OHNope/seeed-xiao-studio-nose-camera/rocket_nose_selfie_camera.kicad_sch

## KiCad design rocket_nose_selfie_camera.kicad_sch (2026-10-16)

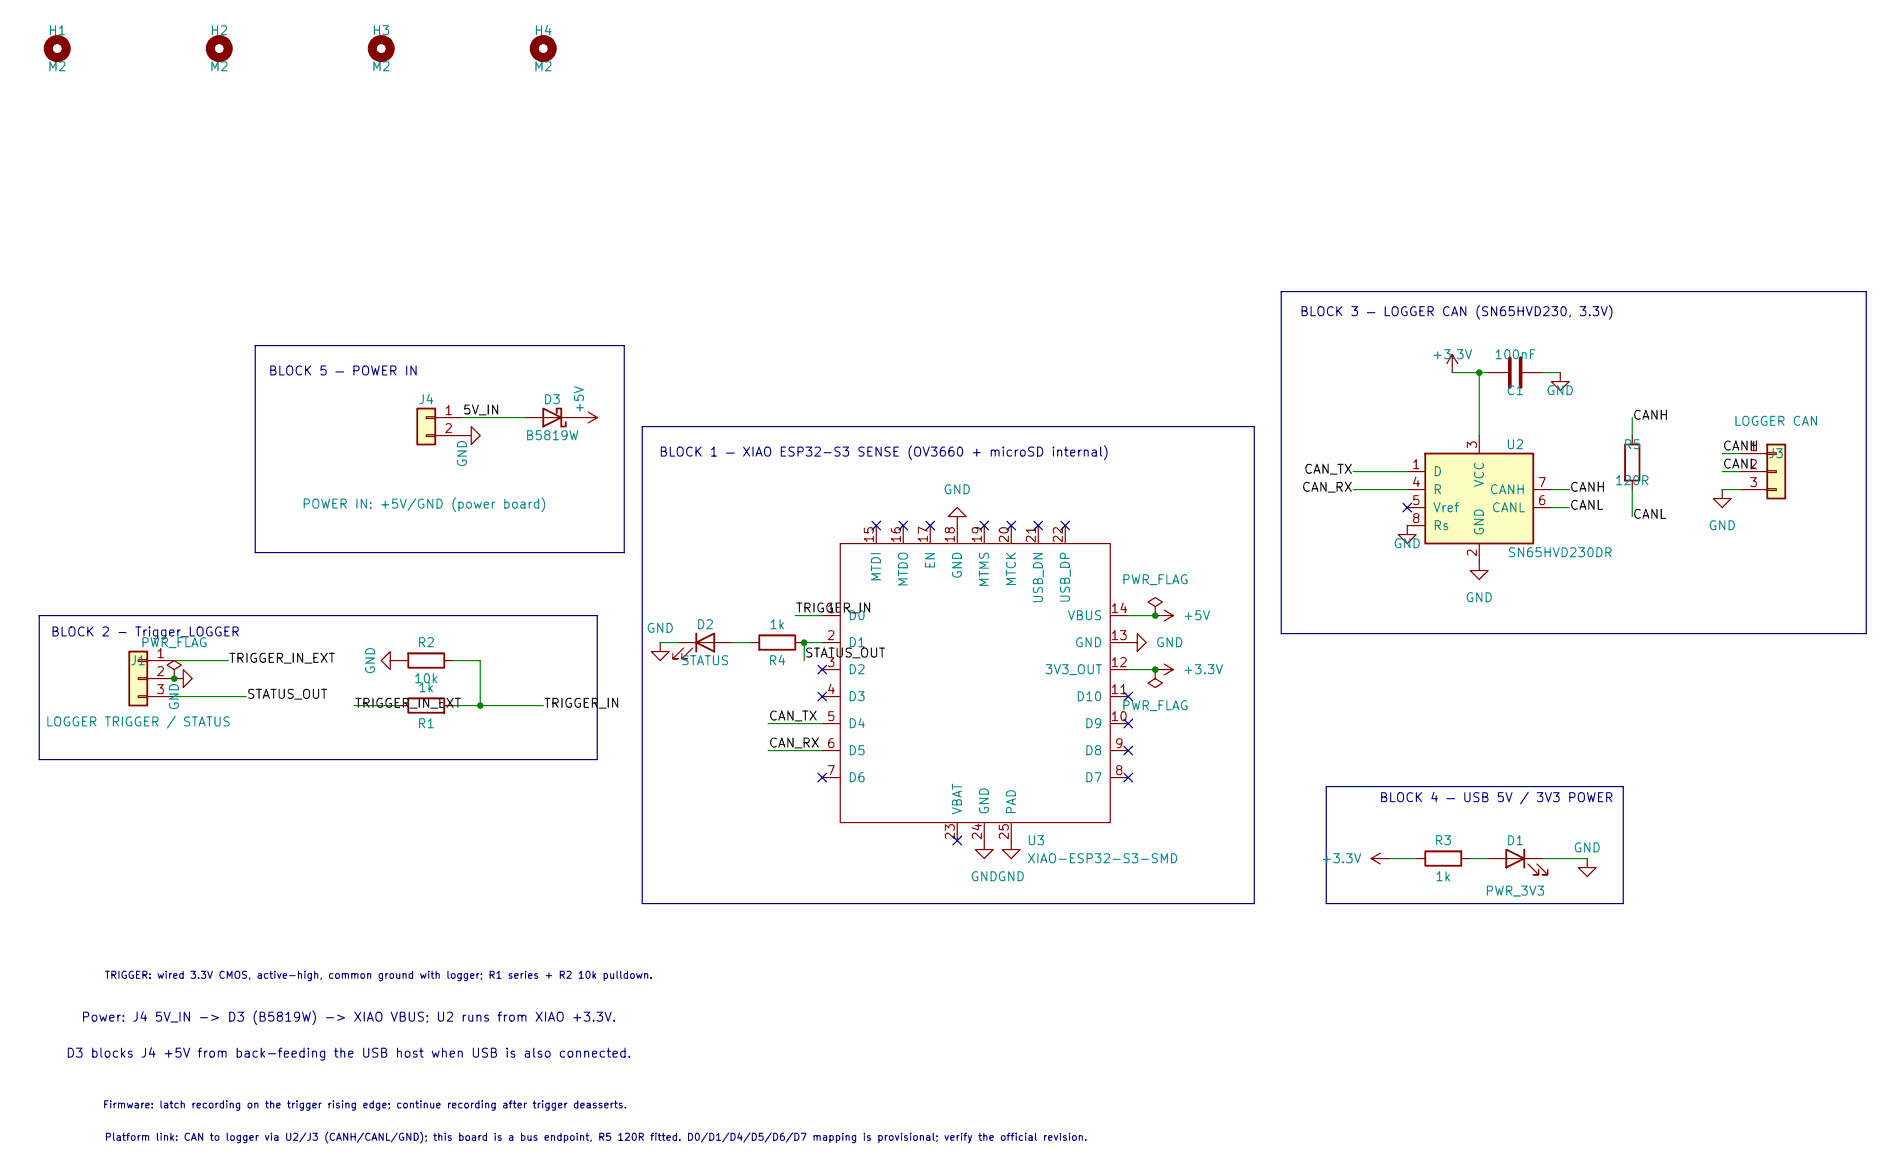
[picture p1: schematic rocket_nose_selfie_camera.kicad_sch]

Parts:
C1: 100nF; C_0603_1608Metric
D1: PWR_3V3; LED_0603_1608Metric
D2: STATUS; LED_0603_1608Metric
D3: B5819W; D_SOD-123
H1, H2, H3, H4: M2; MountingHole_2.2mm_M2
J1: LOGGER TRIGGER / STATUS; PinHeader_1x03_P2.54mm_Vertical
J3: LOGGER CAN; PinHeader_1x03_P2.54mm_Vertical
J4: POWER IN: +5V/GND (power board); PinHeader_1x02_P2.54mm_Vertical
R1, R3, R4: 1k; R_0603_1608Metric
R2: 10k; R_0603_1608Metric
R5: 120R; R_0603_1608Metric
U2: SN65HVD230DR; SOIC-8_3.9x4.9mm_P1.27mm; MPN SN65HVD230DR
U3: XIAO-ESP32-S3-SMD

Connections:
5V_IN: D3.2 (A), J4.1
+3.3V: C1.2, R3.1, U2.3 (VCC), U3.12 (3V3_OUT)
+5V: D3.1 (K), U3.14 (VBUS)
CANH: J3.1, R5.1, U2.7 (CANH)
CANL: J3.2, R5.2, U2.6 (CANL)
CAN_RX: U2.4 (R), U3.6 (D5)
CAN_TX: U2.1 (D), U3.5 (D4)
GND: C1.1, D1.1 (K), D2.1 (K), J1.2, J3.3, J4.2, R2.2, U2.2 (GND), U2.8 (Rs), U3.13 (GND), U3.18 (GND), U3.24 (GND), U3.25 (PAD)
unnamed: D1.2 (A), R3.2
unnamed: D2.2 (A), R4.2
STATUS_OUT: J1.3, R4.1, U3.2 (D1)
TRIGGER_IN: R1.2, R2.1, U3.1 (D0)
TRIGGER_IN_EXT: J1.1, R1.1

Notes on the sheet:
BLOCK 5 — POWER IN
Firmware: latch recording on the trigger rising edge; continue recording after trigger deasserts.
BLOCK 2 - Trigger_LOGGER
BLOCK 3 — LOGGER CAN (SN65HVD230, 3.3V)
Platform link: CAN to logger via U2/J3 (CANH/CANL/GND); this board is a bus endpoint, R5 120R fitted. D0/D1/D4/D5/D6/D7 mapping is provisional; verify the official revision.
TRIGGER: wired 3.3V CMOS, active-high, common ground with logger; R1 series + R2 10k pulldown.
Power: J4 5V_IN -> D3 (B5819W) -> XIAO VBUS; U2 runs from XIAO +3.3V.
BLOCK 1 — XIAO ESP32-S3 SENSE (OV3660 + microSD internal)
BLOCK 4 — USB 5V / 3V3 POWER
D3 blocks J4 +5V from back-feeding the USB host when USB is also connected.
